obono/ATtiny85RomanClock/doc/schematic.png

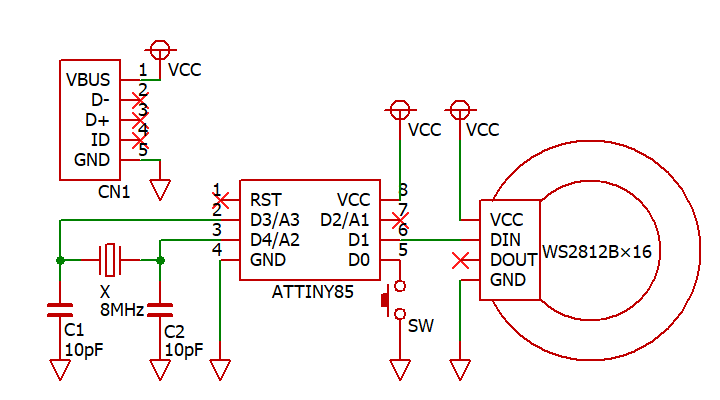
doc/schematic.png
